thequantumturtle/my-first-qubit/enclosure/freecad/README.md

# FreeCAD: start here

The **main assembly** is [MyFirstQubit_iteration03_controls_prototype.FCStd](MyFirstQubit_iteration03_controls_prototype.FCStd). This is the most complete controls/housing engineering concept, **not a finished print-ready toy**.

| CAD document | Purpose |
| --- | --- |
| [Full controls assembly](MyFirstQubit_iteration03_controls_prototype.FCStd) | Primary combined engineering design |
| [Iteration 03 housing](MyFirstQubit_enclosure_iteration03.FCStd) | Basic housing, front panel, and rear tray |
| [PCB160 LCD integration](MyFirstQubit_iteration03_LCD_PCB160.FCStd) | Updated display integration |
| [V0.4 battery proposal](MyFirstQubit_enclosure_v04_battery_proposal.FCStd) | Future battery arrangement, not yet integrated |

**Other FCStd files in this folder are historical iterations, isolated fixtures, or alternative studies.** They remain here to preserve potential FreeCAD external references and original design provenance.

## Supporting files

- [Reference screenshots and diagrams](support/visuals/)
- [Engineering reviews](support/reviews/)
- [Validation reports and dimensions](support/validation/)
- [Build, audit, and export scripts](support/scripts/)
- [Available printable STL fit-test packages](../prints/)
- [Enclosure documentation](../README.md)

Note: Scripts are historical development tools; inspect machine-specific paths and update them before running. The full enclosure has not been validated as a complete physical assembly. This is an adult-operated engineering prototype, not a child-safe product.
