thequantumturtle/my-first-qubit/enclosure/freecad/controls-prototype-axonometric.png

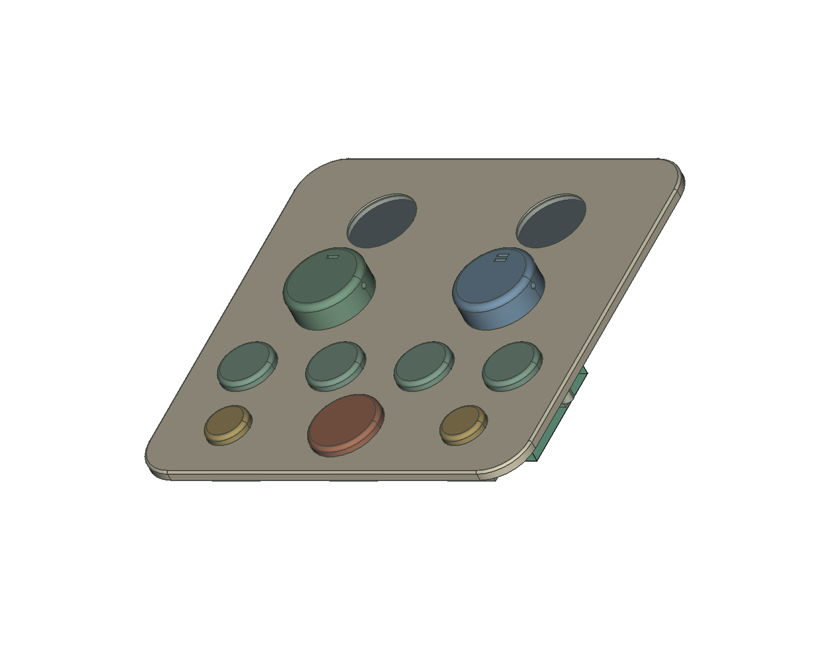
enclosure/freecad/controls-prototype-axonometric.png
