thequantumturtle/my-first-qubit/enclosure/freecad/controls-prototype-top.png

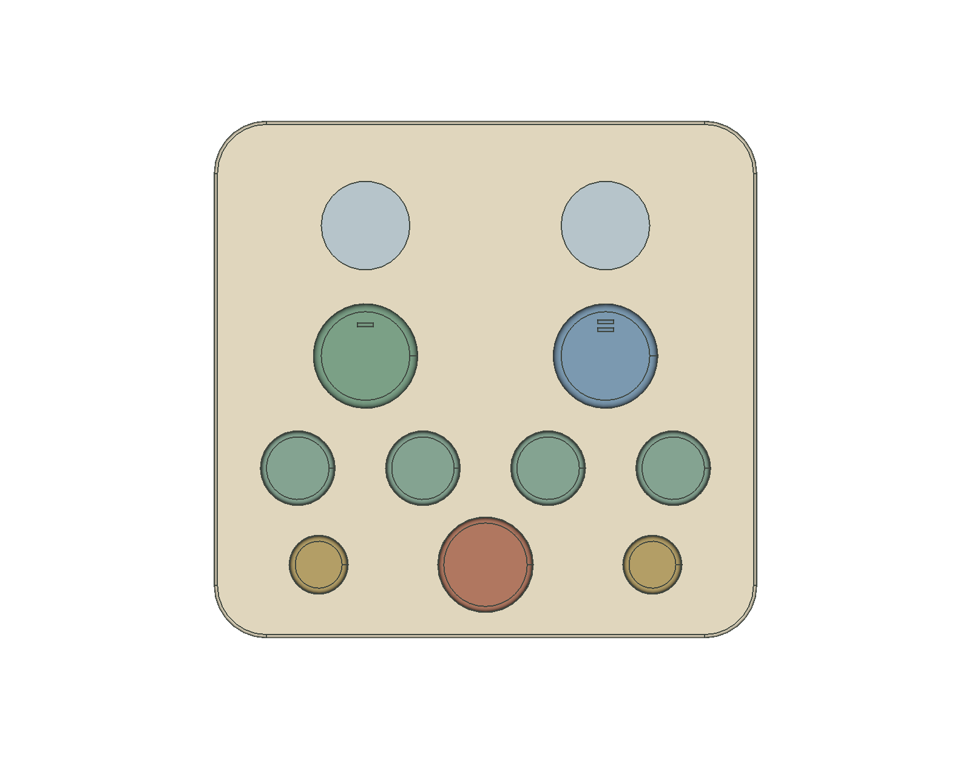
enclosure/freecad/controls-prototype-top.png
