thequantumturtle/my-first-qubit/enclosure/freecad/gate-fixture-section.png

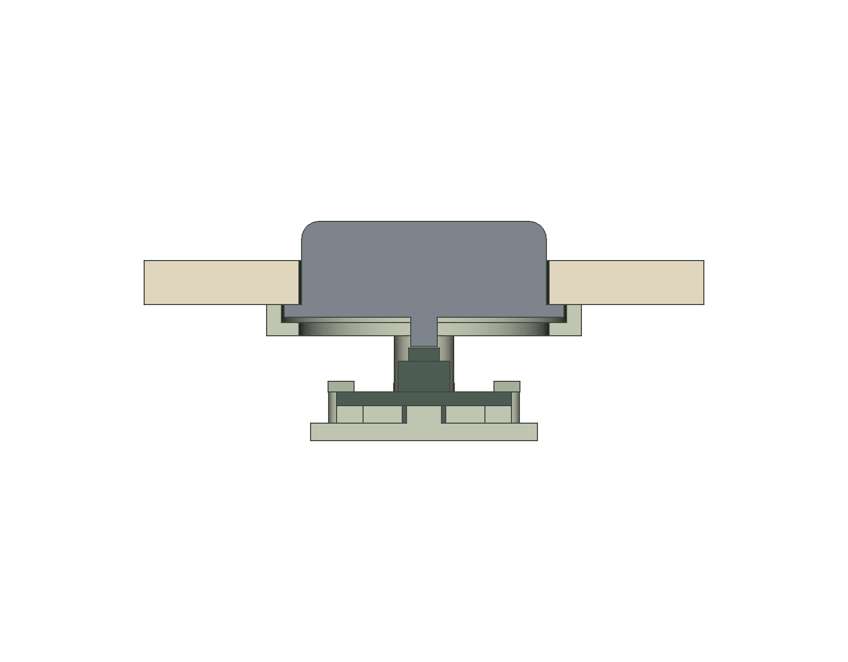
enclosure/freecad/gate-fixture-section.png
