thequantumturtle/my-first-qubit/enclosure/freecad/iteration03-candidate-LCD-inside.png

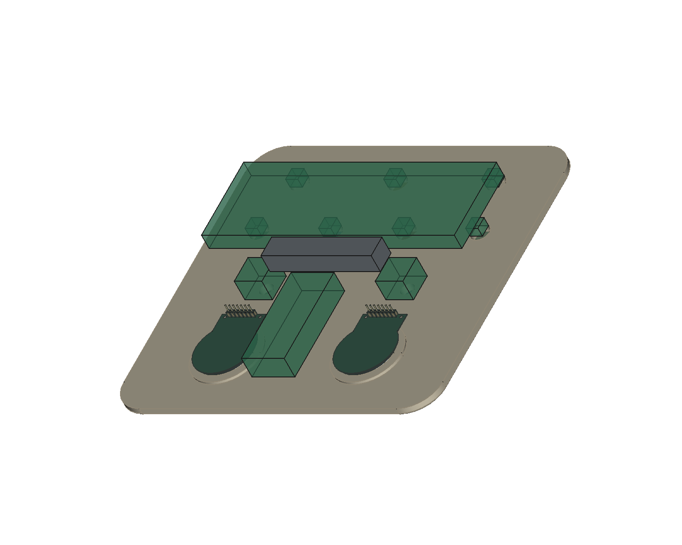
enclosure/freecad/iteration03-candidate-LCD-inside.png
