thequantumturtle/my-first-qubit/enclosure/freecad/iteration03-lcd-exploded.png

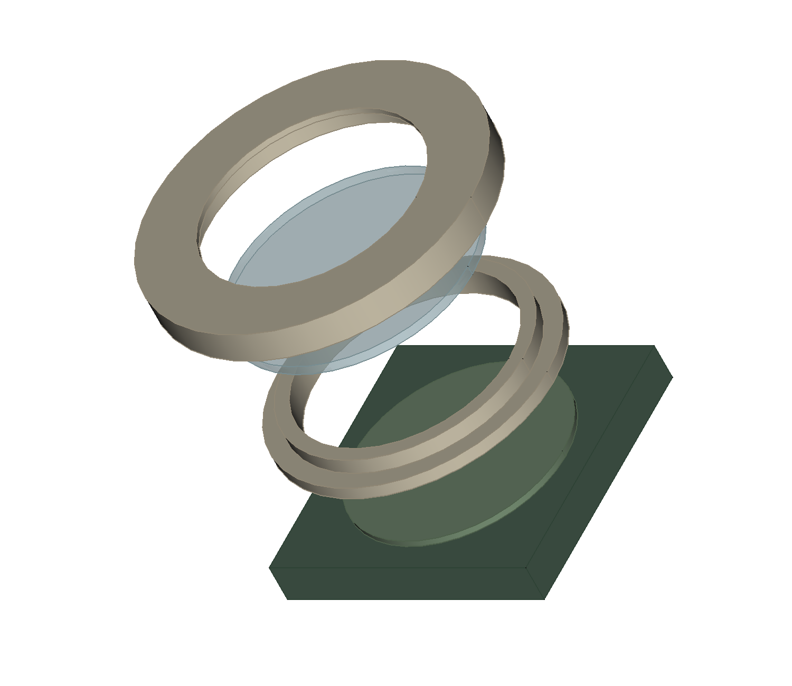
enclosure/freecad/iteration03-lcd-exploded.png
