thequantumturtle/my-first-qubit/enclosure/freecad/support/visuals/encoder-fixture-exploded.png

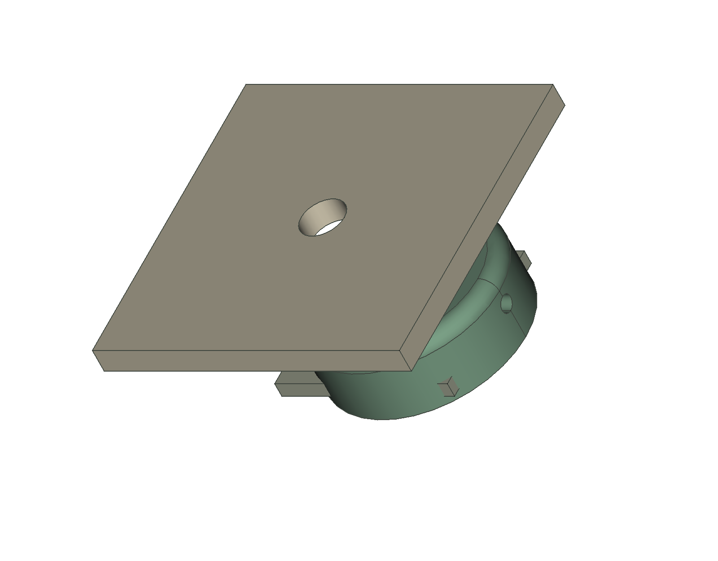
enclosure/freecad/support/visuals/encoder-fixture-exploded.png
