thequantumturtle/my-first-qubit/hardware/components.md

# V0.1 component inventory

| Item | Qty | Status |
| --- | ---: | --- |
| ESP32-S3 N8R8 DevKitC-style board | 1 | Received; flashed successfully |
| Dorhea 1.28-inch GC9A01 7-pin SPI LCD | 2 | Received; independent color fills verified |
| OFNMY breadboard/wire/resistor/LED kit | 1 | Received |
| 6×6 mm momentary pushbutton assortment | 1 | Received; bench use only |
| Bourns PEC11R-4225F-S0024 encoder | 6 | Ordered; awaiting arrival |
| Multimeter | 1 | Already owned |

## Deferred

- Two premium walnut knobs for 6 mm D-flat shafts.
- Six larger panel-mounted buttons (four colored gates, Measure, Reset).
- Wooden enclosure, protected windows, strain relief and secure control retention.

Confirm exact hardware and shaft fit before making enclosure holes. Do not use exposed bench hardware as a toddler toy.
