thequantumturtle/my-first-qubit/enclosure/freecad/MyFirstQubit_iteration03_LCD_mechanical_integration.FCStd

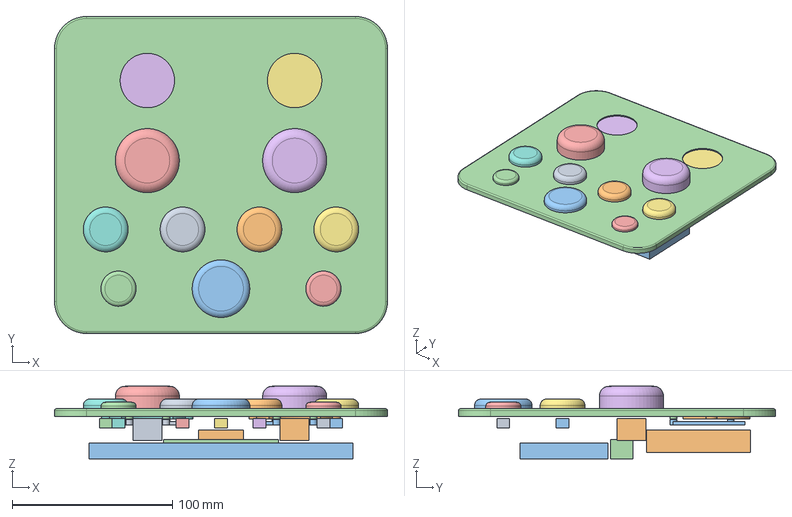
[picture p7: CAD file, 2026-11-06]
enclosure/freecad/MyFirstQubit_iteration03_LCD_mechanical_integration.FCStd
208.0 x 198.0 x 45.3 mm
Probability encoder - TBD envelope
Phase encoder - TBD envelope
H switch - TBD envelope
X switch - TBD envelope
Y switch - TBD envelope
Z switch - TBD envelope
Measure switch - TBD envelope
Reset switch - TBD envelope
Colors switch - TBD envelope
ESP32-S3 - TBD envelope, USB position unmodeled
Breadboard - TBD planning envelope, not measured assembly
Wiring reserve only - not a routed harness
Probability knob rounded concept - no bore or retention
Phase knob rounded concept - no bore or retention
H button rounded concept - guidance and retention TBD
X button rounded concept - guidance and retention TBD
Y button rounded concept - guidance and retention TBD
Z button rounded concept - guidance and retention TBD
Measure button rounded concept - guidance and retention TBD
Reset button rounded concept - guidance and retention TBD
Colors button rounded concept - guidance and retention TBD
Left clear polycarbonate lens - 1.5 mm provisional
Right clear polycarbonate lens - 1.5 mm provisional
Left removable lens ring - M2 proposal, retention unvalidated
Left screw-removable LCD cradle - verify four backside contact lands
Right removable lens ring - M2 proposal, retention unvalidated
Right screw-removable LCD cradle - verify four backside contact lands
Front housing with blind rear pilots, PCB standoffs, lens and connector pockets
