thequantumturtle/my-first-qubit/enclosure/prints/encoder-knob-fit-test/encoder-test-panel.stl

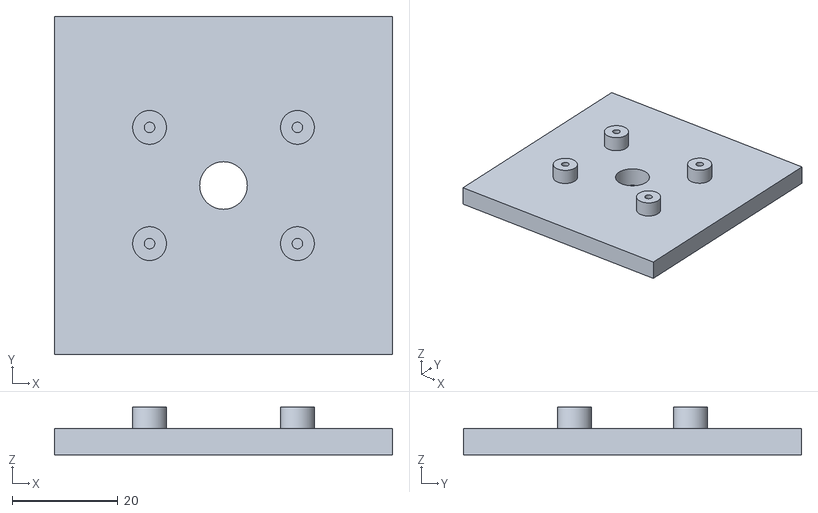
[picture p8: CAD file, 2026-11-06]
enclosure/prints/encoder-knob-fit-test/encoder-test-panel.stl
64.0 x 64.0 x 9.00
