thequantumturtle/my-first-qubit/enclosure/prints/lcd-fit-test-pcb160/lcd-fit-panel-pcb160.stl

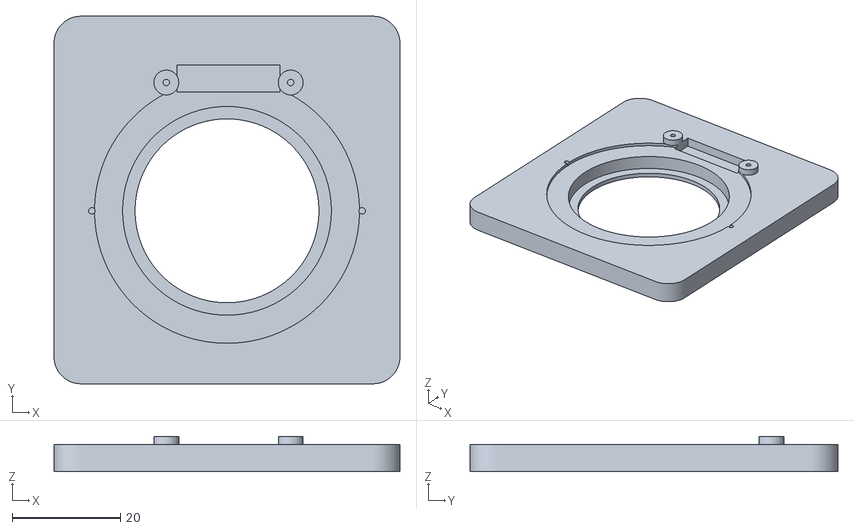
[picture p9: CAD file, 2026-11-06]
enclosure/prints/lcd-fit-test-pcb160/lcd-fit-panel-pcb160.stl
64.0 x 68.0 x 6.50
