thequantumturtle/my-first-qubit/enclosure/prints/lcd-fit-test/lcd-rear-cradle.stl

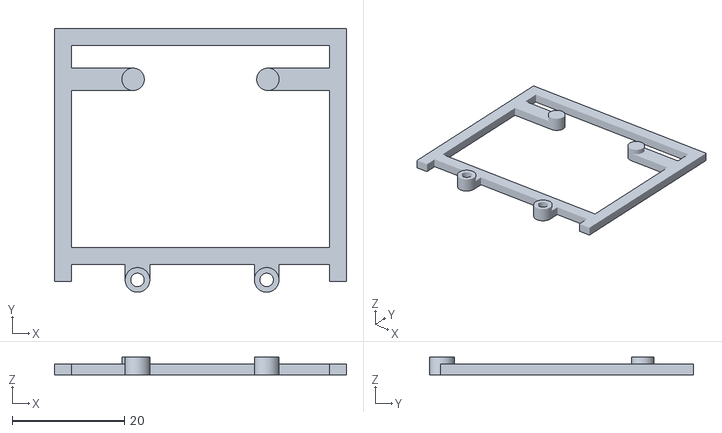
[picture p10: CAD file, 2026-11-06]
enclosure/prints/lcd-fit-test/lcd-rear-cradle.stl
52.0 x 46.9 x 3.20
