thequantumturtle/my-first-qubit/hardware/models/gc9a01-meta-mcu/GC9A01_META_MCU_candidate.FCStd

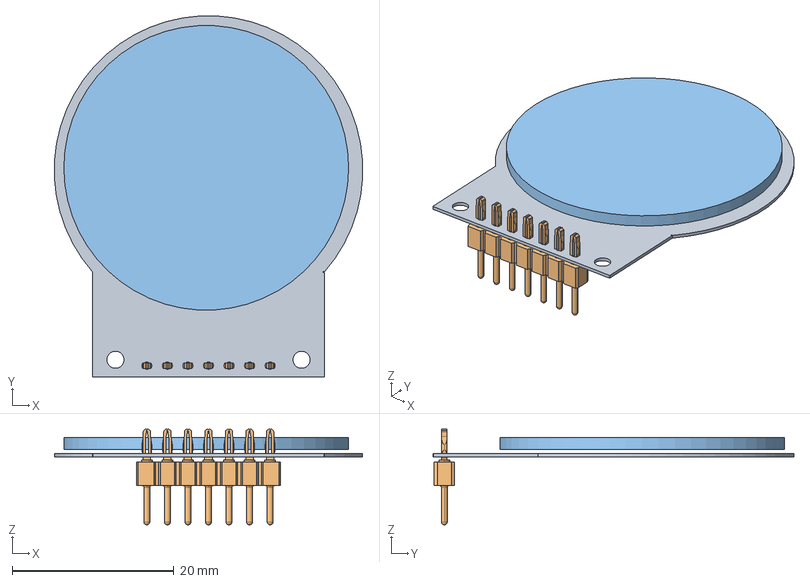
[picture p11: CAD file, 2026-11-06]
hardware/models/gc9a01-meta-mcu/GC9A01_META_MCU_candidate.FCStd
38.1 x 44.6 x 11.8 mm
PCBReference - upstream BRep, not a Dorhea measurement
ConnectorReference - upstream BRep, not a Dorhea measurement
DisplayBodyReference - upstream BRep, not a Dorhea measurement
