thequantumturtle/my-first-qubit/enclosure/freecad/MyFirstQubit_enclosure_iteration01.FCStd

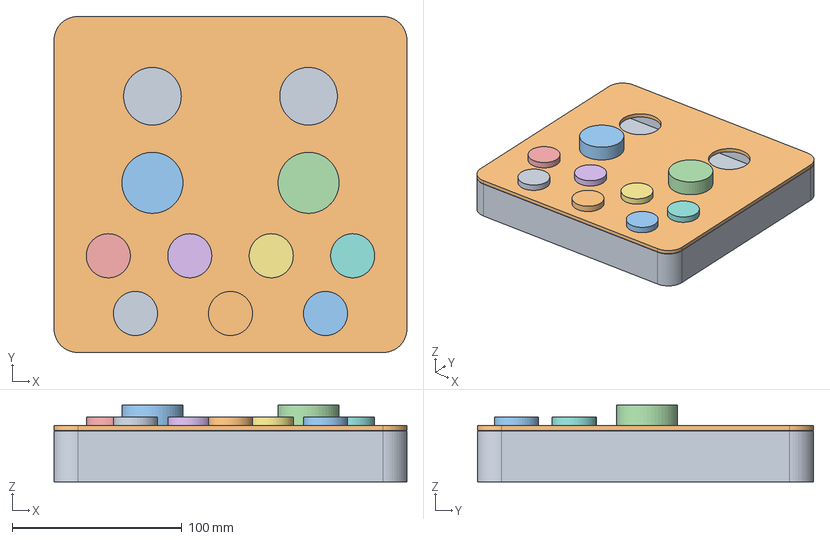
[picture p12: CAD file, 2026-11-06]
enclosure/freecad/MyFirstQubit_enclosure_iteration01.FCStd
208.0 x 198.0 x 45.3 mm
Base tray - closure and mounts TBD
Front panel - 2 LCD + 2 encoder + 7 button openings, all TBD
Probability knob concept - no bore or retention
Phase knob concept - no bore or retention
H button concept - guidance and retention TBD
X button concept - guidance and retention TBD
Y button concept - guidance and retention TBD
Z button concept - guidance and retention TBD
Measure button concept - guidance and retention TBD
Reset button concept - guidance and retention TBD
Colors button concept - guidance and retention TBD
