thequantumturtle/my-first-qubit/enclosure/prints/encoder-knob-fit-test/balance-knob.stl

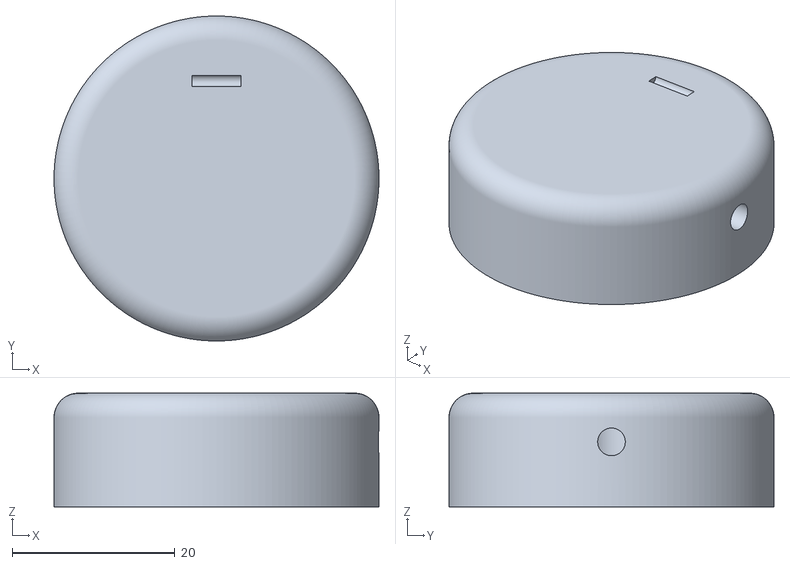
[picture p13: CAD file, 2026-11-06]
enclosure/prints/encoder-knob-fit-test/balance-knob.stl
40.0 x 40.0 x 14.0
