thequantumturtle/my-first-qubit/enclosure/freecad/MyFirstQubit_enclosure_v04_battery_proposal.FCStd

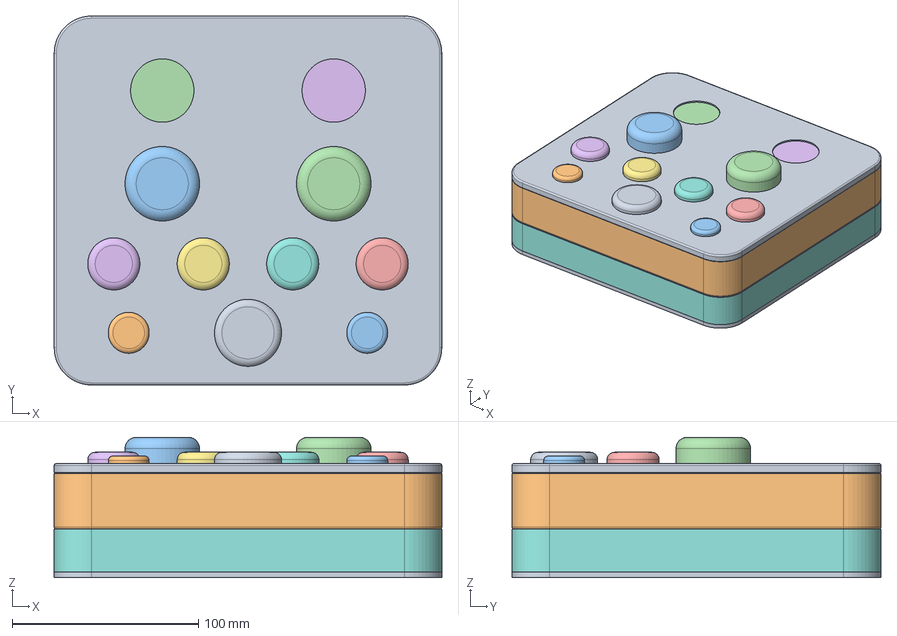
[picture p14: CAD file, 2026-11-06]
enclosure/freecad/MyFirstQubit_enclosure_v04_battery_proposal.FCStd
208.0 x 198.0 x 75.3 mm
Warm cream front housing - inner lip captures lens from front
Removable rear tray concept - rear closure/fasteners TBD
Probability knob rounded concept - no bore or retention
Phase knob rounded concept - no bore or retention
H button rounded concept - guidance and retention TBD
X button rounded concept - guidance and retention TBD
Y button rounded concept - guidance and retention TBD
Z button rounded concept - guidance and retention TBD
Measure button rounded concept - guidance and retention TBD
Reset button rounded concept - guidance and retention TBD
Colors button rounded concept - guidance and retention TBD
Left clear polycarbonate lens - 1.5 mm provisional
Left LCD active-surface proxy - location and diameter TBD
Right clear polycarbonate lens - 1.5 mm provisional
Right LCD active-surface proxy - location and diameter TBD
Lower battery layer - joint and secure attachment unresolved
Underside cover - REQUIRE screw security; fasteners/capture not modeled
