thequantumturtle/my-first-qubit/enclosure/freecad/MyFirstQubit_measure_button_fixture_PROVISIONAL.FCStd

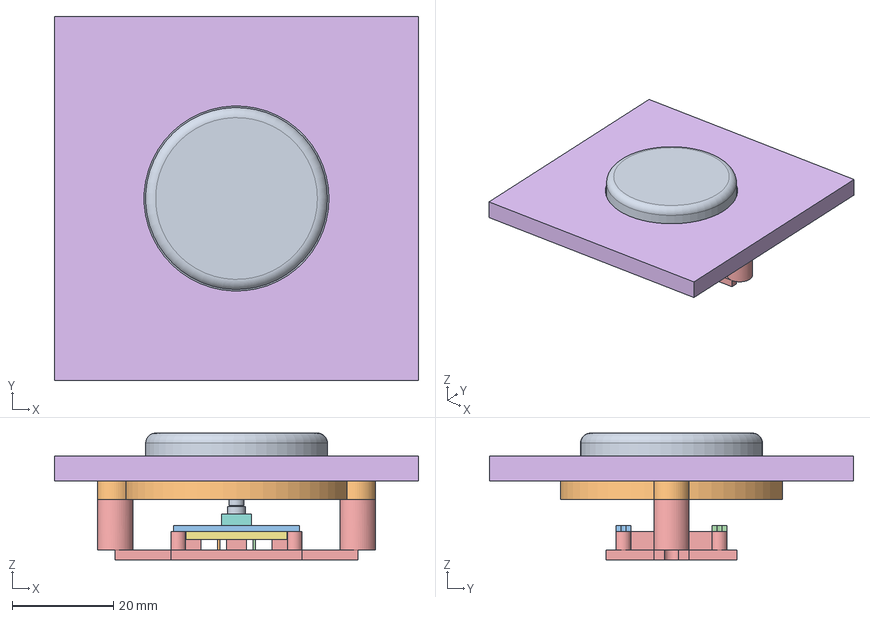
[picture p15: CAD file, 2026-11-06]
enclosure/freecad/MyFirstQubit_measure_button_fixture_PROVISIONAL.FCStd
72.0 x 72.0 x 25.1 mm
Measure captive cap - travel/actuation provisional
MeasureRearGuideAndStop
MeasureRemovablePCBClip0
MeasureRemovablePCBClip1
Measure load-supported switch carrier - PCB clip contacts/pilots provisional
MeasureTestPanel
MeasureSwitchPCB_TBD
MeasureTactileSwitch_TBD
MeasureActuator_TBD
MeasurePin_TBD0
MeasurePin_TBD1
MeasurePin_TBD2
MeasurePin_TBD3
