thequantumturtle/my-first-qubit/enclosure/freecad/MyFirstQubit_encoder_knob_fixture.FCStd

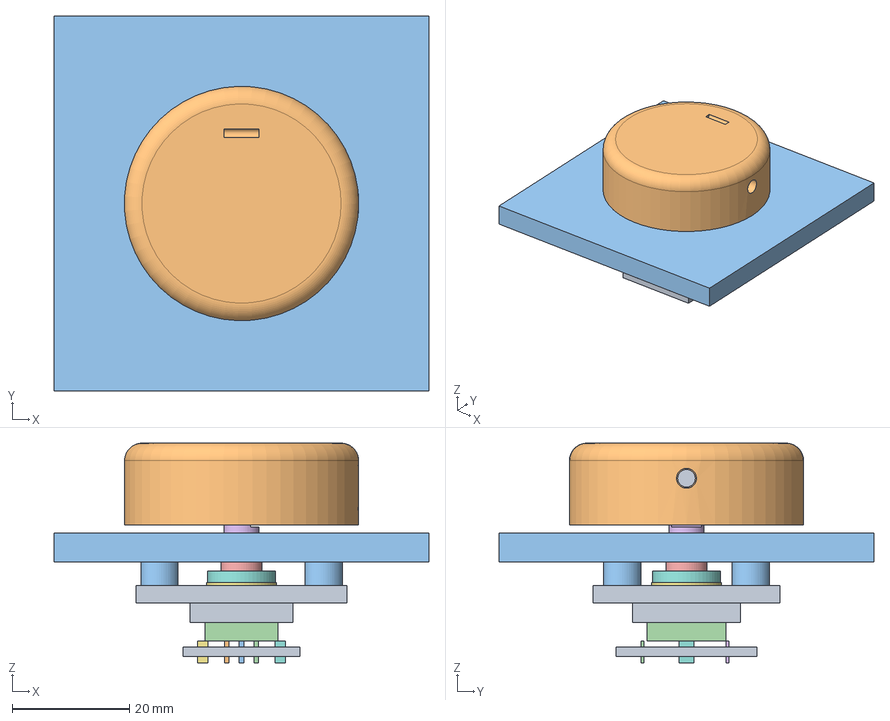
[picture p16: CAD file, 2026-11-06]
enclosure/freecad/MyFirstQubit_encoder_knob_fixture.FCStd
64.0 x 64.0 x 37.5 mm
BalanceRearBulkhead
Balance removable rounded knob - one groove / Balance
EncoderTestPanel
Balance Bourns simplified body - manufacturer nominal
M7 x 0.75 threaded interface envelope - threads not modeled
BalanceFlattedShaft
BalanceWasher
M7 x 0.75 nut envelope (10 AF), threads not modeled
Unselected 20 x 24 mm interconnect PCB envelope; no fabricated hole pattern
BalanceACB0 drawing XY / provisional Z reach (unconnected tabs/push terminals)
BalanceACB1 drawing XY / provisional Z reach (unconnected tabs/push terminals)
BalanceACB2 drawing XY / provisional Z reach (unconnected tabs/push terminals)
BalanceUnusedPushPin0 drawing XY / provisional Z reach (unconnected tabs/push terminals)
BalanceUnusedPushPin1 drawing XY / provisional Z reach (unconnected tabs/push terminals)
BalanceMountTab0 drawing XY / provisional Z reach (unconnected tabs/push terminals)
BalanceMountTab1 drawing XY / provisional Z reach (unconnected tabs/push terminals)
Candidate M3 x 16 grub screw envelope - threads/retention unqualified
Candidate M3 hex nut 5.5 AF x 2.4 - verify actual hardware
