thequantumturtle/my-first-qubit/enclosure/freecad/MyFirstQubit_gate_button_fixture_PROVISIONAL.FCStd

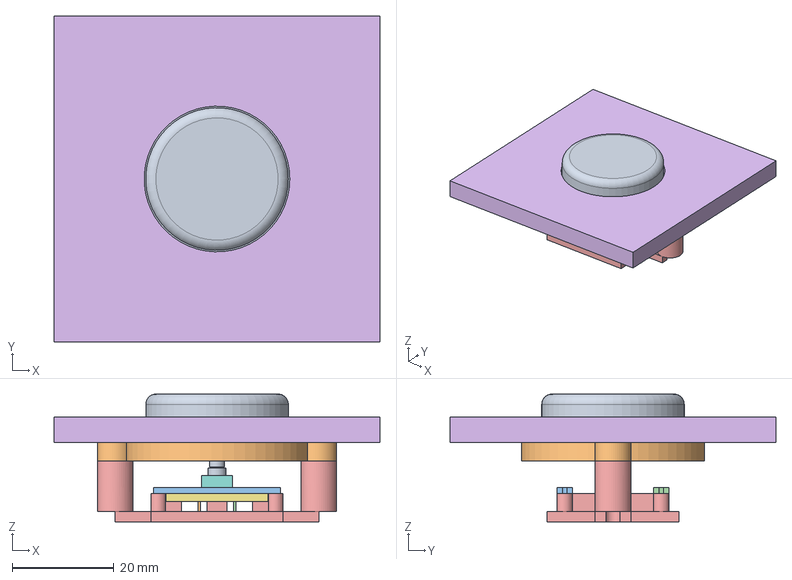
[picture p17: CAD file, 2026-11-06]
enclosure/freecad/MyFirstQubit_gate_button_fixture_PROVISIONAL.FCStd
64.0 x 64.0 x 25.1 mm
Gate captive cap - travel/actuation provisional
GateRearGuideAndStop
GateRemovablePCBClip0
GateRemovablePCBClip1
Gate load-supported switch carrier - PCB clip contacts/pilots provisional
GateTestPanel
GateSwitchPCB_TBD
GateTactileSwitch_TBD
GateActuator_TBD
GatePin_TBD0
GatePin_TBD1
GatePin_TBD2
GatePin_TBD3
