thequantumturtle/my-first-qubit/(list of files, cad)

Other CAD files:
enclosure/freecad/MyFirstQubit_iteration03_LCD_PCB160.FCStd
