thequantumturtle/my-first-qubit/(commit log)

2026-10-16 Add hardware/wiring.md
2026-10-16 Add enclosure/README.md
2026-10-16 Add .github/workflows/arduino.yml
2026-10-16 Speed up qubit animations with faster SPI and skip unnecessary redraws
2026-10-17 Declare palette accessor after its type for Arduino preprocessing
2026-10-17 Add debounced physical H button on GPIO 4
2026-10-19 Document all seven button connections and input behavior
2026-10-19 Support debounced X Y Z H measure reset and palette buttons
2026-10-19 Document two encoder connections, step sizes and bench tests
2026-10-19 Add interrupt-driven probability and relative-phase encoders
2026-10-19 Place encoder ISR after custom type definitions for Arduino
2026-10-19 Move encoders to GPIO 1/2 and 41/42
2026-10-19 Use requested encoder pins: probability 1/2, phase 41/42
2026-10-19 Document detent-aligned encoder counting and phase-preserving end stops
2026-10-19 Preserve phase at probability limits and align counts with encoder detents
2026-10-19 Record V0.2 hardware-tested breadboard milestone and final wiring
2026-10-21 Add parametric enclosure and printable LCD fit-test assembly
2026-10-21 Refine LCD mechanical model using 1.6mm PCB reference
2026-10-21 Export revised PCB160 LCD fit-test print package
2026-10-24 Add encoder knob and captive button mechanical prototypes
2026-11-06 docs: make enclosure CAD and printable fit tests easy to find
2026-11-06 docs: link current enclosure CAD and print packages from root README
2026-11-06 Repair references within relocated CAD engineering reviews
2026-11-06 Repair enclosure and print package links after FreeCAD organization
